WoodworkingDennis/ESP32_Watercooling_3D-Printer/README.md

<h1>ESP32_Watercooling_3D-Printer</h1>
<p>
</br>Ansteuerung von drei unabhängingen PWM-Geräten
</br>Auslesen von sechs verschiedenen PT100 Widerständen
</br>Anzeige und Einstellungen über LCD-Display
</br>ESP32 auf Custom PCB
</p>
