WoodworkingDennis/ESP32_Watercooling_3D-Printer/Custum PCB Design (KiCAD)/Schematic.pdf

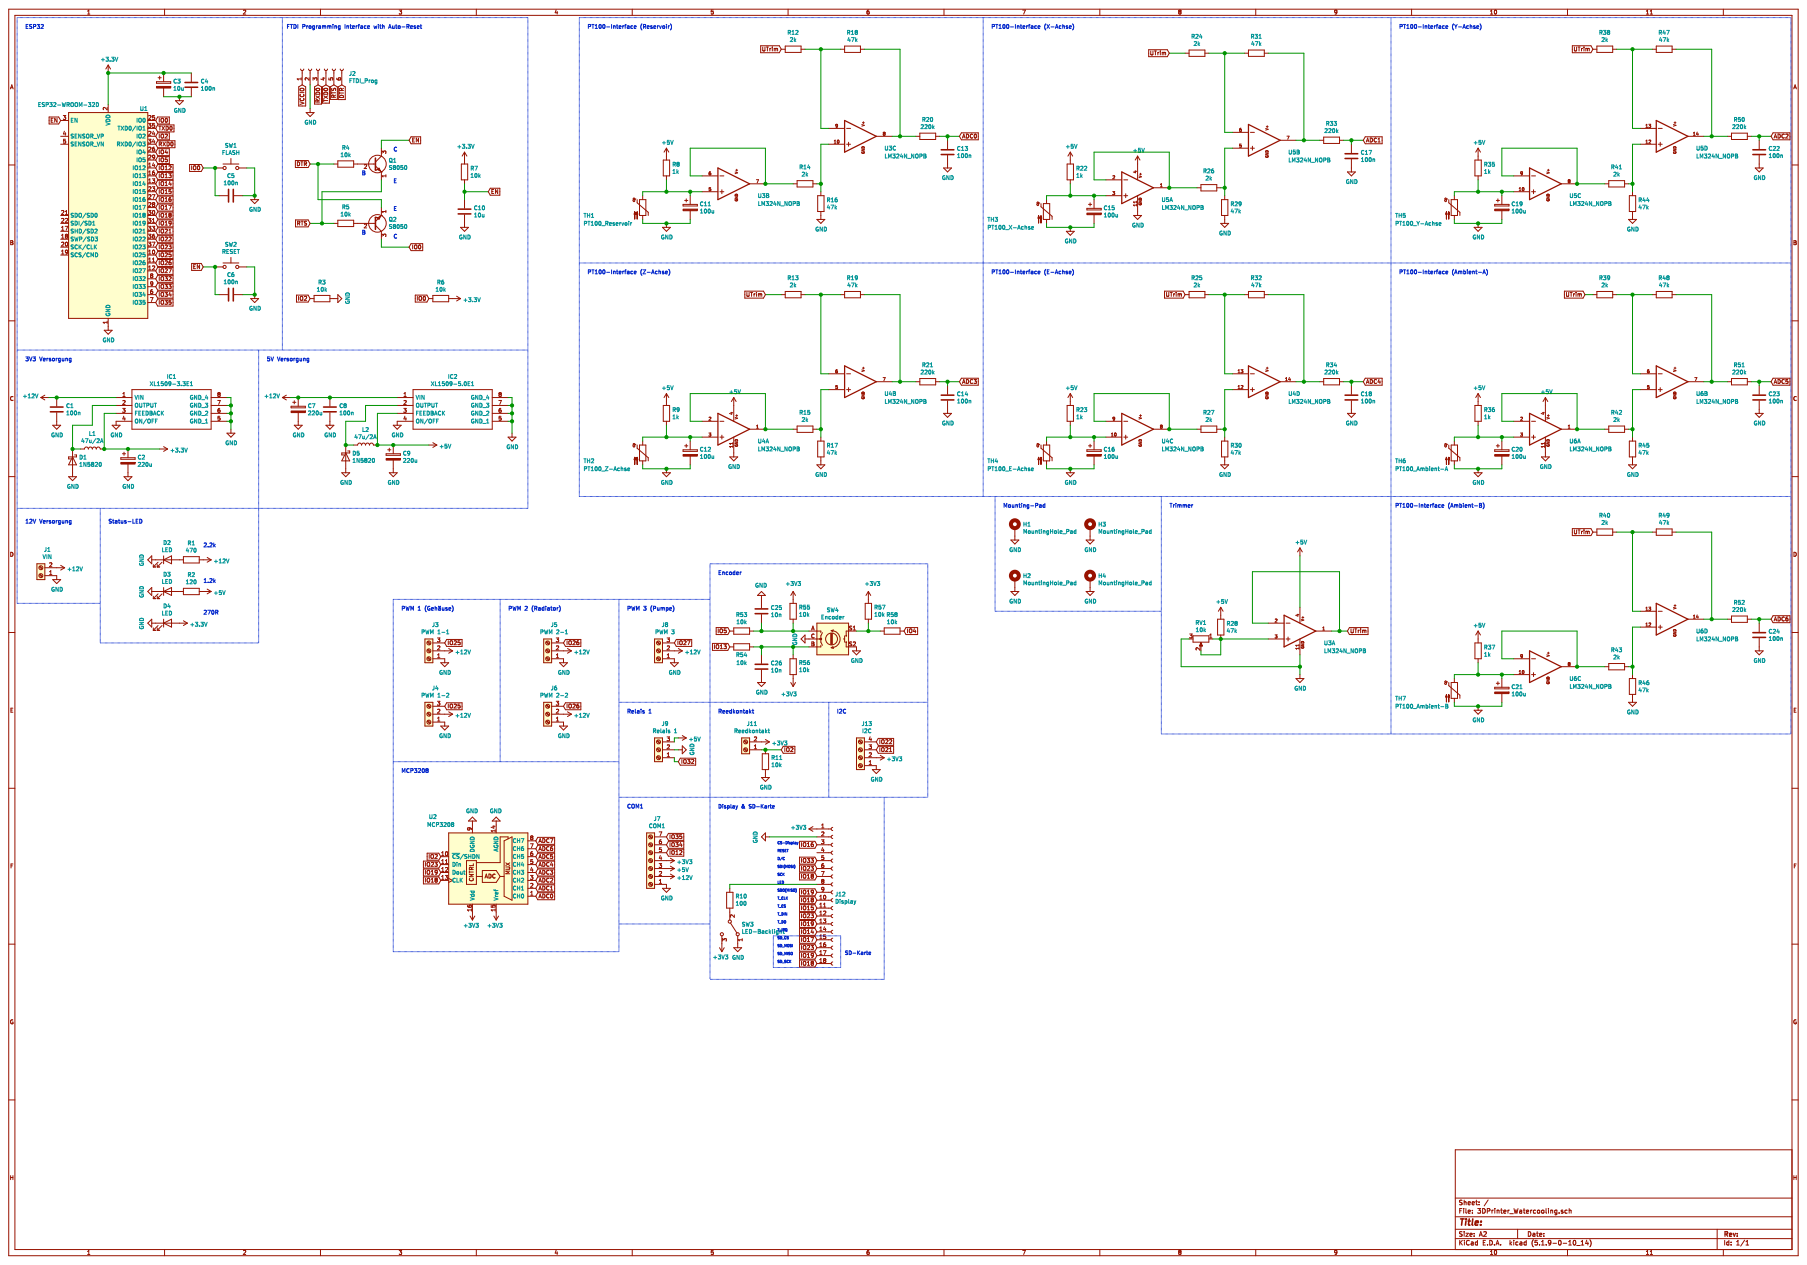
[picture p1: page 1]
