WoodworkingDennis/ESP32_Watercooling_3D-Printer/(list of files, drawings)

Other design files:
Custum PCB Design (KiCAD)/3DPrinter_Watercooling.dsn
