WoodworkingDennis/ESP32_Watercooling_3D-Printer/Custum PCB Design (KiCAD)/3DPrinter_Watercooling.kicad_pcb

## KiCad design Custum PCB Design (KiCAD)/3DPrinter_Watercooling.kicad_pcb (2021-02-17)

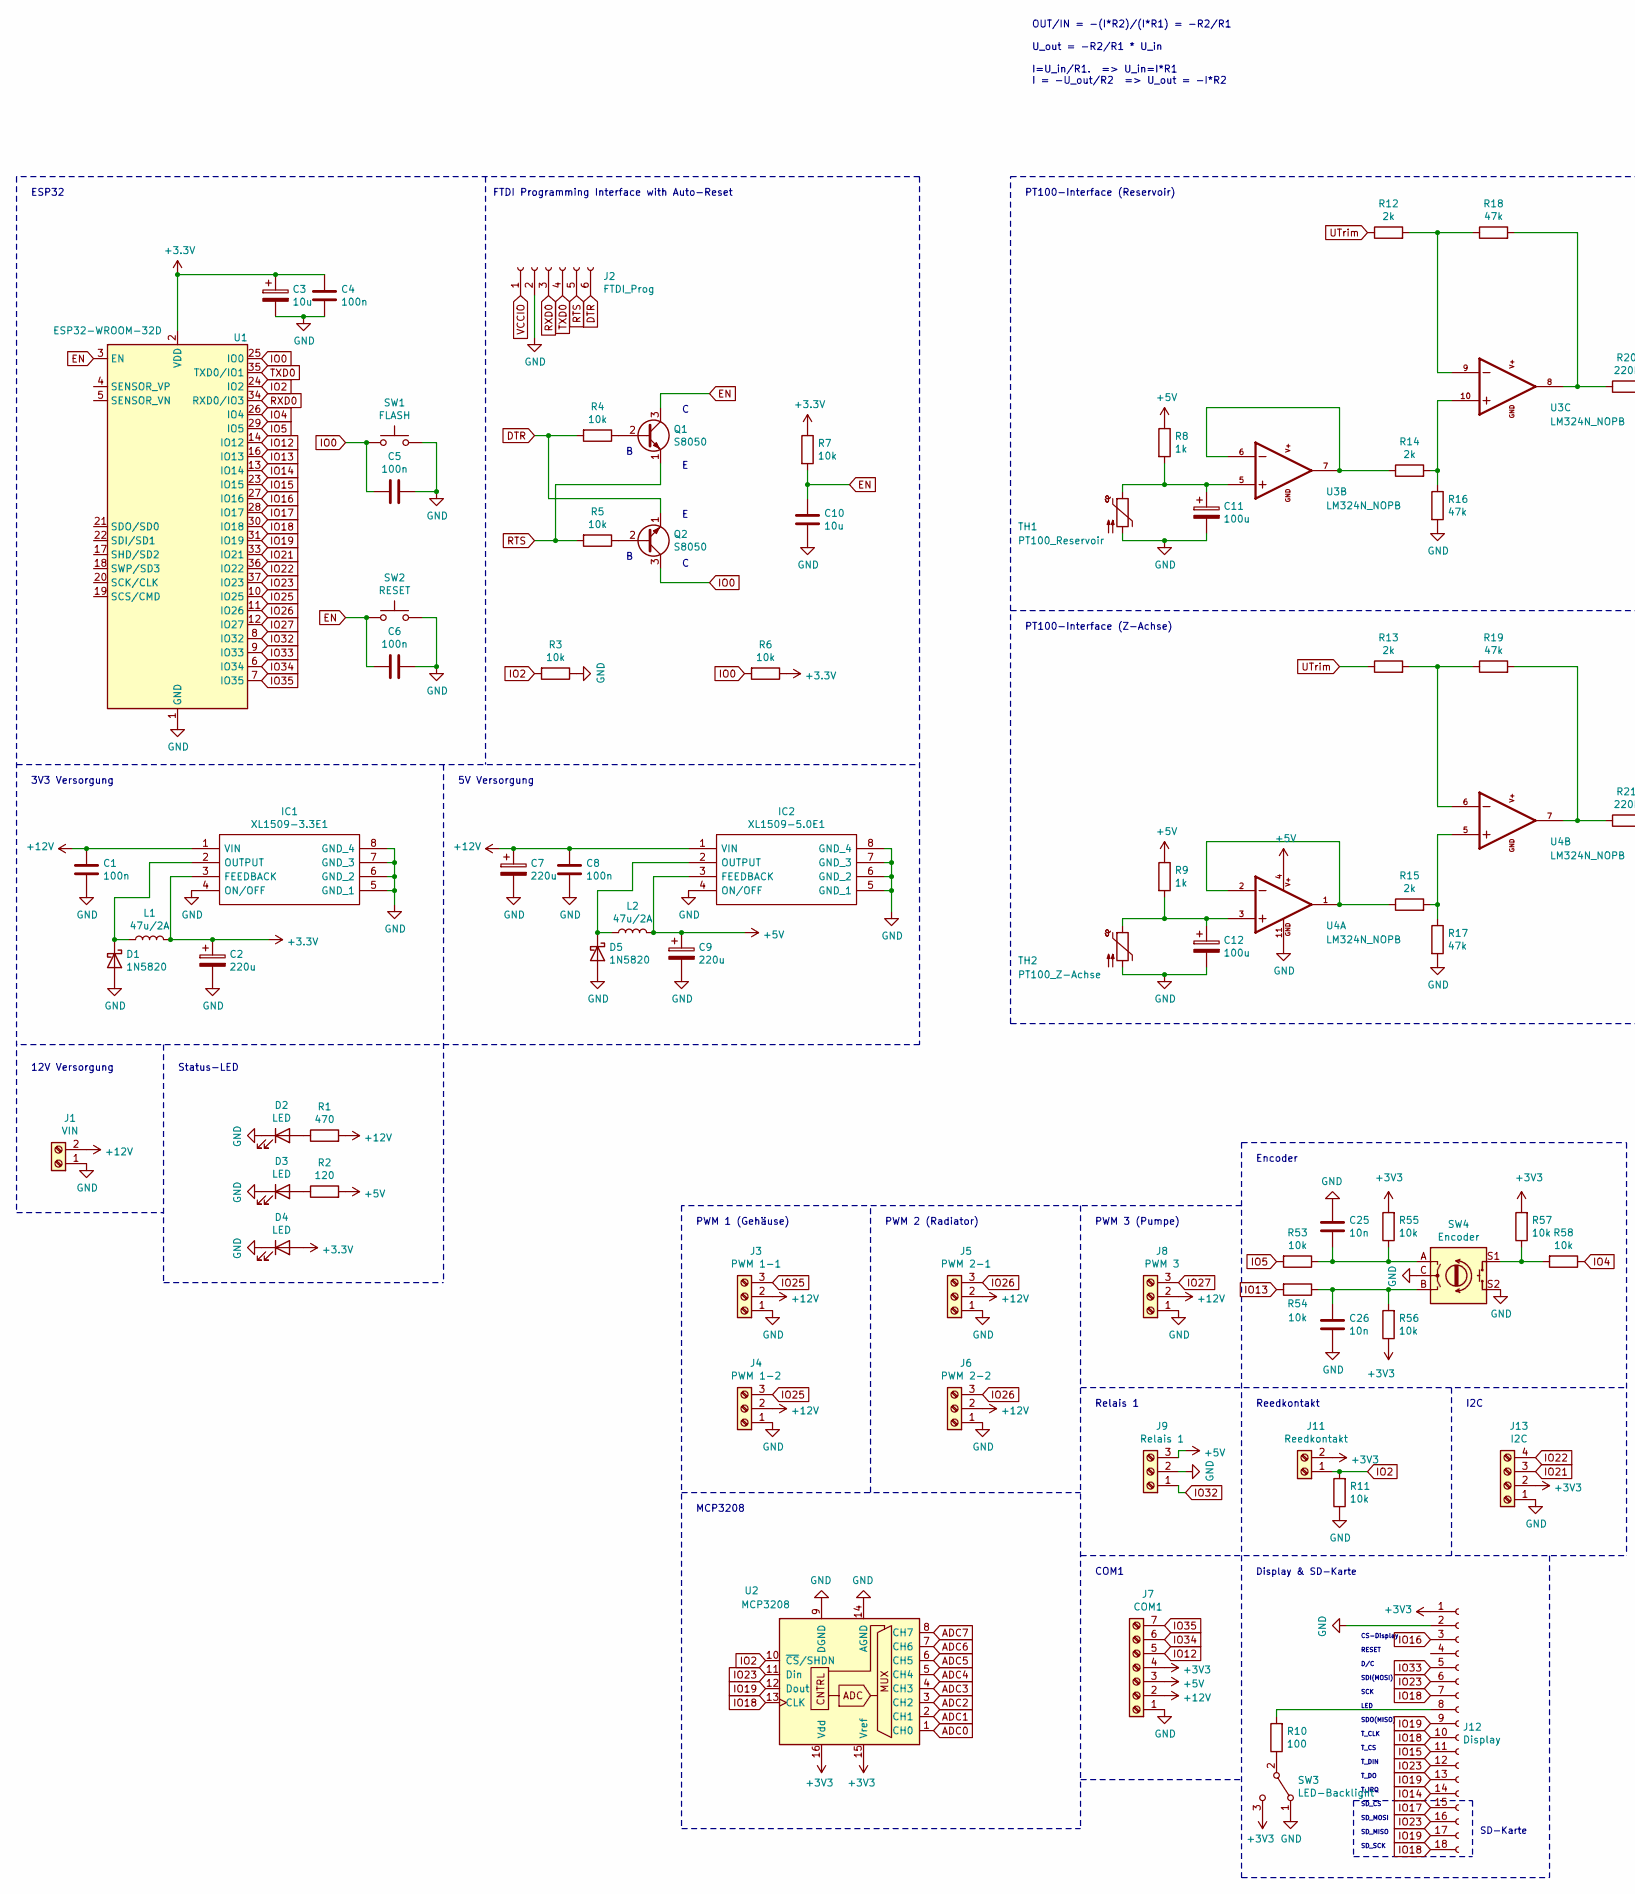
[picture p2: schematic 3DPrinter_Watercooling.sch, part in row 1, column 1]

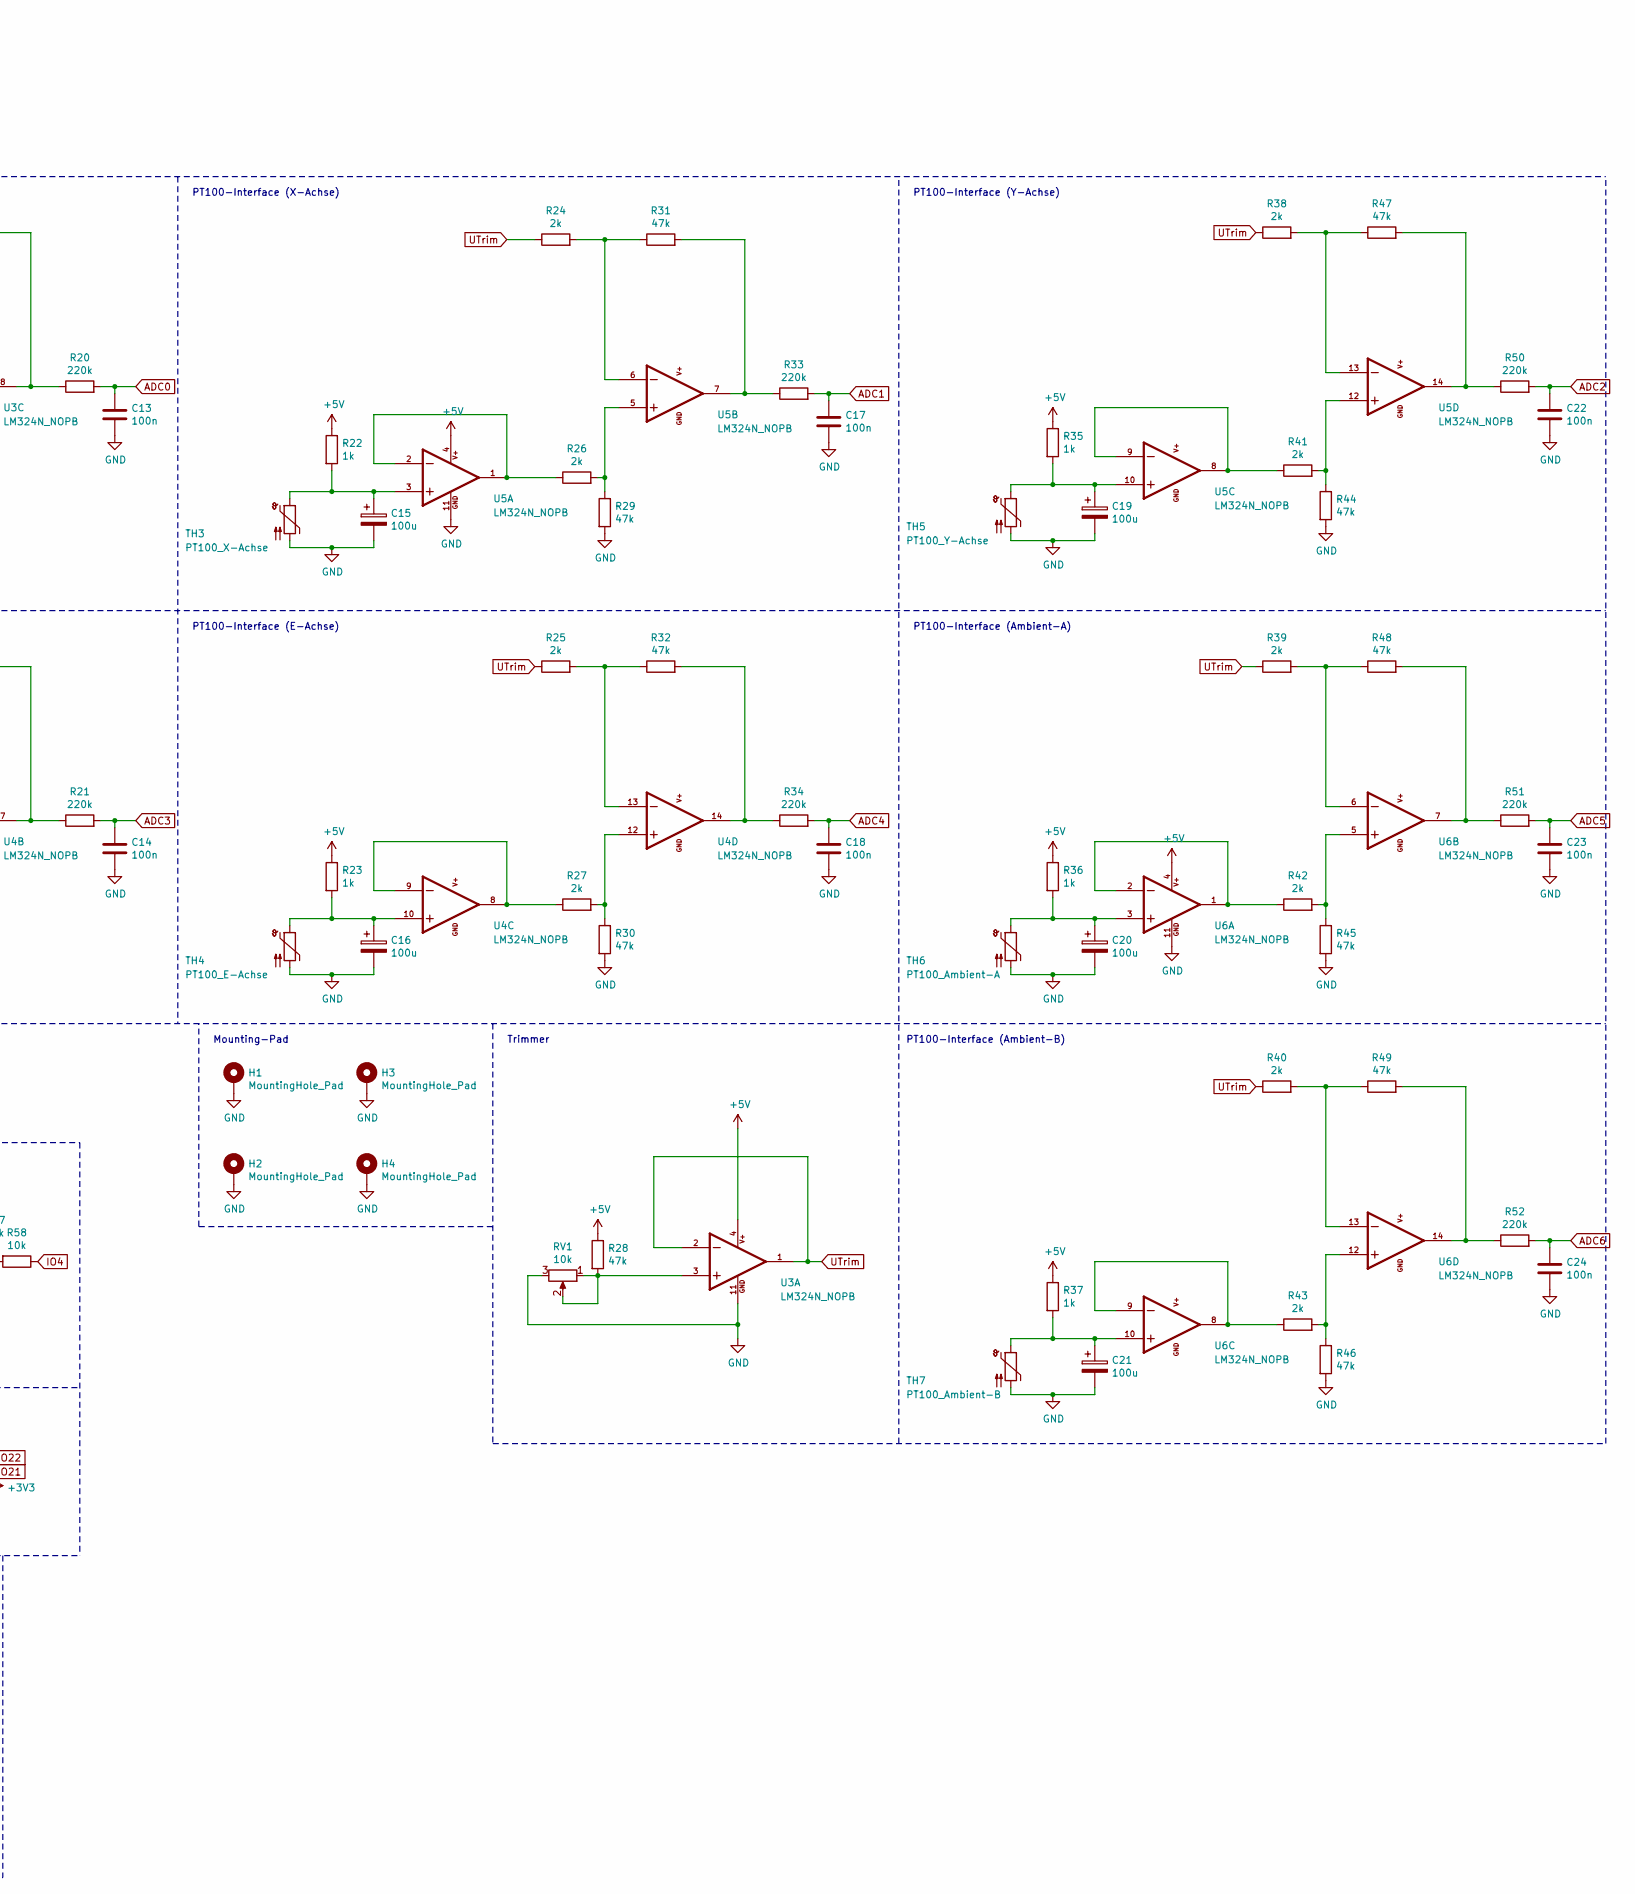
[picture p3: schematic 3DPrinter_Watercooling.sch, part in row 1, column 2]

Parts:
C1, C4, C5, C6, C8, C13, C14, C17, C18, C22, C23, C24: 100n; C_0805_2012Metric_Pad1.18x1.45mm_HandSolder
C2, C7, C9: 220u; CP_Radial_D6.3mm_P2.50mm
C3: 10u; CP_Radial_D4.0mm_P1.50mm
C10: 10u; C_0805_2012Metric_Pad1.18x1.45mm_HandSolder
C11, C12, C15, C16, C19, C20, C21: 100u; CP_Radial_D5.0mm_P2.00mm
C25, C26: 10n; C_0805_2012Metric_Pad1.18x1.45mm_HandSolder
D1, D5: 1N5820; D_DO-201AD_P15.24mm_Horizontal
D2, D3, D4: LED; LED_0805_2012Metric_Pad1.15x1.40mm_HandSolder
H1, H2, H3, H4: MountingHole_Pad; MountingHole_2.2mm_M2_Pad_Via
IC1: XL1509-3.3E1; SOIC127P600X175-8N; Manufacturer_Part_Number XL1509-3.3E1
IC2: XL1509-5.0E1; SOIC127P600X175-8N; Manufacturer_Part_Number XL1509-5.0E1
J1: VIN; WJ301V-5.0-2P
J2: FTDI_Prog; PinHeader_1x06_P2.54mm_Vertical
J3: PWM 1-1; TE_282834-3
J4: PWM 1-2; TE_282834-3
J5: PWM 2-1; TE_282834-3
J6: PWM 2-2; TE_282834-3
J7: COM1; TE_282834-7
J8: PWM 3; TE_282834-3
J9: Relais 1; TE_282834-3
J11: Reedkontakt; TE_282834-2
J12: Display; 3.2 inch 320 240 SPI Serial TFT LCD Module
J13: I2C; TE_282834-4
L1, L2: 47u/2A; L_Radial_D10.0mm_P5.00mm_Fastron_07M
Q1, Q2: S8050; TO-92_Inline
R1: 470; R_Axial_DIN0207_L6.3mm_D2.5mm_P7.62mm_Horizontal
R2: 120; R_Axial_DIN0207_L6.3mm_D2.5mm_P7.62mm_Horizontal
R3, R4, R5, R6, R7, R11, R53, R54, R55, R56, R57, R58: 10k; R_Axial_DIN0207_L6.3mm_D2.5mm_P7.62mm_Horizontal
R8, R9, R22, R23, R35, R36, R37: 1k; R_Axial_DIN0207_L6.3mm_D2.5mm_P7.62mm_Horizontal
R10: 100; R_Axial_DIN0207_L6.3mm_D2.5mm_P7.62mm_Horizontal
R12, R13, R14, R15, R24, R25, R26, R27, R38, R39, R40, R41, R42, R43: 2k; R_Axial_DIN0207_L6.3mm_D2.5mm_P7.62mm_Horizontal
R16, R17, R18, R19, R28, R29, R30, R31, R32, R44, R45, R46, R47, R48, R49: 47k; R_Axial_DIN0207_L6.3mm_D2.5mm_P7.62mm_Horizontal
R20, R21, R33, R34, R50, R51, R52: 220k; R_Axial_DIN0207_L6.3mm_D2.5mm_P7.62mm_Horizontal
RV1: 10k; Potentiometer_Bourns_3296W_Vertical
SW1: FLASH; TS-1187A-B-A-B
SW2: RESET; TS-1187A-B-A-B
SW3: LED-Backlight; SW_Slide_1P2T_CK_OS102011MS2Q
SW4: Encoder; RotaryEncoder_Alps_EC11E-Switch_Vertical_H20mm
TH1: PT100_Reservoir; TE_282834-2
TH2: PT100_Z-Achse; TE_282834-2
TH3: PT100_X-Achse; TE_282834-2
TH4: PT100_E-Achse; TE_282834-2
TH5: PT100_Y-Achse; TE_282834-2
TH6: PT100_Ambient-A; TE_282834-2
TH7: PT100_Ambient-B; TE_282834-2
U1: ESP32-WROOM-32D; ESP32-WROOM-32
U2: MCP3208; SOIC127P600X175-16N
U3, U4, U5, U6: LM324N_NOPB; SOIC-14_3.9x8.7mm_P1.27mm; PARTREV D

Connections:
+5V: C9.1, IC2.3 (FEEDBACK), J7.3, J9.3, L2.2, R2.2, R8.1, R9.1, R22.1, R23.1, R28.1, R35.1, R36.1, R37.1, U3.4, U4.4, U5.4, U6.4
+12V: C1.1, C7.1, C8.1, IC1.1 (VIN), IC2.1 (VIN), J1.2, J3.2, J4.2, J5.2, J6.2, J7.2, J8.2, R1.2
ADC0: C13.1, R20.2, U2.1 (CH0)
ADC1: C17.1, R33.2, U2.2 (CH1)
ADC2: C22.1, R50.2, U2.3 (CH2)
ADC3: C14.1, R21.2, U2.4 (CH3)
ADC4: C18.1, R34.2, U2.5 (CH4)
ADC5: C23.1, R51.2, U2.6 (CH5)
ADC6: C24.1, R52.2, U2.7 (CH6)
ADC7: U2.8 (CH7)
DTR: J2.6, Q2.1 (E), R4.2
EN: C6.2, C10.1, Q1.3 (C), R7.2, SW2.1, U1.3 (EN)
GND: C1.2, C2.2, C3.2, C4.2, C5.1, C6.1, C7.2, C8.2, C9.2, C10.2, C11.2, C12.2, C13.2, C14.2, C15.2, C16.2, C17.2, C18.2, C19.2, C20.2, C21.2, C22.2, C23.2, C24.2, C25.1, C26.2, D1.2 (A), D2.1 (K), D3.1 (K), D4.1 (K), D5.2 (A), H1.1, H2.1, H3.1, H4.1, IC1.4 (ON/OFF), IC1.5 (GND_1), IC1.6 (GND_2), IC1.7 (GND_3), IC1.8 (GND_4), IC2.4 (ON/OFF), IC2.5 (GND_1), IC2.6 (GND_2), IC2.7 (GND_3), IC2.8 (GND_4), J1.1, J2.2, J3.1, J4.1, J5.1, J6.1, J7.1, J8.1, J9.2, J12.2, J13.1, R3.1, R11.1, R16.2, R17.2, R29.2, R30.2, R44.2, R45.2, R46.2, RV1.3, SW1.2, SW2.2, SW3.1 (A), SW4.C, SW4.S2, TH1.2, TH2.2, TH3.2, TH4.2, TH5.2, TH6.2, TH7.2, U1.1 (GND), U1.15 (GND), U1.38 (GND), U1.39 (GND), U2.9 (DGND), U2.14 (AGND), U3.11, U4.11, U5.11, U6.11
IO0: C5.2, Q2.3 (C), R6.2, SW1.1, U1.25 (IO0)
IO2: J11.1, R3.2, R11.2, U1.24 (IO2), U2.10 (~CS~/SHDN)
IO4: R58.1, U1.26 (IO4)
IO5: R53.2, U1.29 (IO5)
IO12: J7.5, U1.14 (IO12)
IO13: R54.2, U1.16 (IO13)
IO14: J12.14, U1.13 (IO14)
IO15: J12.11, U1.23 (IO15)
IO16: J12.3, U1.27 (IO16)
IO17: J12.15, U1.28 (IO17)
IO18: J12.7, J12.10, J12.18, U1.30 (IO18), U2.13 (CLK)
IO19: J12.9, J12.13, J12.17, U1.31 (IO19), U2.12 (Dout)
IO21: J13.3, U1.33 (IO21)
IO22: J13.4, U1.36 (IO22)
IO23: J12.6, J12.12, J12.16, U1.37 (IO23), U2.11 (Din)
IO25: J3.3, J4.3, U1.10 (IO25)
IO26: J5.3, J6.3, U1.11 (IO26)
IO27: J8.3, U1.12 (IO27)
IO32: J9.1, U1.8 (IO32)
IO33: J12.5, U1.9 (IO33)
IO34: J7.6, U1.6 (IO34)
IO35: J7.7, U1.7 (IO35)
unnamed: C11.1, R8.2, TH1.1, U3.5
unnamed: C12.1, R9.2, TH2.1, U4.3
unnamed: C15.1, R22.2, TH3.1, U5.3
unnamed: C16.1, R23.2, TH4.1, U4.10
unnamed: C19.1, R35.2, TH5.1, U5.10
unnamed: C20.1, R36.2, TH6.1, U6.3
unnamed: C21.1, R37.2, TH7.1, U6.10
unnamed: C25.2, R53.1, R55.1, SW4.A
unnamed: C26.1, R54.1, R56.2, SW4.B
unnamed: D1.1 (K), IC1.2 (OUTPUT), L1.1
unnamed: D2.2 (A), R1.1
unnamed: D3.2 (A), R2.1
unnamed: D5.1 (K), IC2.2 (OUTPUT), L2.1
unnamed: J12.8, R10.2
unnamed: Q1.2 (B), R4.1
unnamed: Q2.2 (B), R5.1
unnamed: R10.1, SW3.2 (B)
unnamed: R12.2, R18.1, U3.9
unnamed: R13.2, R19.1, U4.6
unnamed: R14.1, U3.6, U3.7
unnamed: R14.2, R16.1, U3.10
unnamed: R15.1, U4.1, U4.2
unnamed: R15.2, R17.1, U4.5
unnamed: R18.2, R20.1, U3.8
unnamed: R19.2, R21.1, U4.7
unnamed: R24.2, R31.1, U5.6
unnamed: R25.2, R32.1, U4.13
unnamed: R26.1, U5.1, U5.2
unnamed: R26.2, R29.1, U5.5
unnamed: R27.1, U4.8, U4.9
unnamed: R27.2, R30.1, U4.12
unnamed: R28.2, RV1.1, RV1.2, U3.3
unnamed: R31.2, R33.1, U5.7
unnamed: R32.2, R34.1, U4.14
unnamed: R38.2, R47.1, U5.13
unnamed: R39.2, R48.1, U6.6
unnamed: R40.2, R49.1, U6.13
unnamed: R41.1, U5.8, U5.9
unnamed: R41.2, R44.1, U5.12
unnamed: R42.1, U6.1, U6.2
unnamed: R42.2, R45.1, U6.5
unnamed: R43.1, U6.8, U6.9
unnamed: R43.2, R46.1, U6.12
unnamed: R47.2, R50.1, U5.14
unnamed: R48.2, R51.1, U6.7
unnamed: R49.2, R52.1, U6.14
unnamed: R57.1, R58.2, SW4.S1
RTS: J2.5, Q1.1 (E), R5.2
RXD0: J2.3, U1.34 (RXD0/IO3)
TXD0: J2.4, U1.35 (TXD0/IO1)
UTrim: R12.1, R13.1, R24.1, R25.1, R38.1, R39.1, R40.1, U3.1, U3.2
VCCIO: J2.1

Notes on the sheet:
ESP32
FTDI Programming Interface with Auto-Reset
PT100-Interface (Reservoir)
Mounting-Pad
PT100-Interface (X-Achse)
PT100-Interface (Y-Achse)
PT100-Interface (Z-Achse)
PT100-Interface (Ambient-A)
PT100-Interface (Ambient-B)
Display & SD-Karte
SD-Karte
SD_SCK
SD_MISO
SD_MOSI
SD_CS
T_IRQ
T_DO
T_DIN
T_CS
T_CLK
SDO(MISO)
LED
SCK
SDI(MOSI)
D/C
RESET
CS-Display
COM1
MCP3208
Reedkontakt
Relais 1
Encoder
PWM 3 (Pumpe)
PWM 2 (Radiator)
PWM 1 (Gehäuse)
3V3 Versorgung
12V Versorgung
OUT/IN = -(I*R2)/(I*R1) = -R2/R1 U_out = -R2/R1 * U_in I=U_in/R1. => U_in=I*R1 I = -U_out/R2 => U_out = -I*R2
Trimmer
PT100-Interface (E-Achse)
I2C
5V Versorgung
Status-LED

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
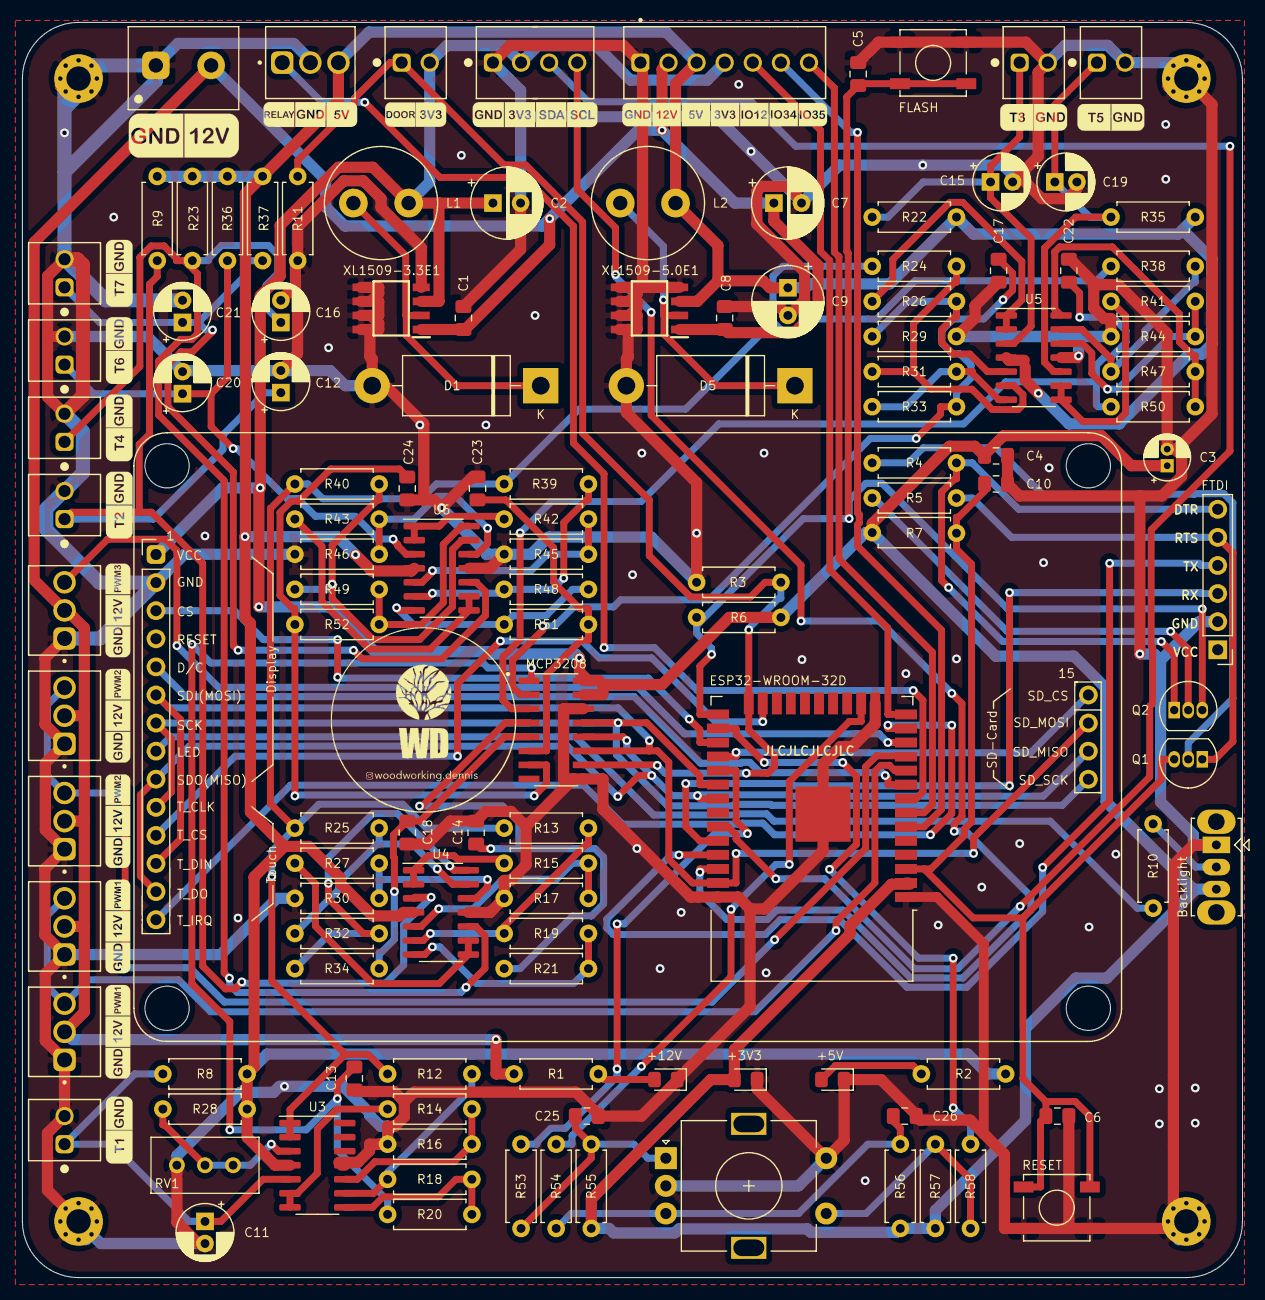
[picture p4: board 3DPrinter_Watercooling.kicad_pcb from above]

Board: 2 copper layers, 110.3 x 113.5 mm, 146 parts (0 on the bottom side), 86 nets.

Other parts of the board:
G1: LOGO; T5-GND_6x2.4 mm
G2: LOGO; T3-GND_6x2.4 mm
G3: LOGO; COM1
G4: LOGO; I2C
G5: LOGO; DOOR-3V3
G6: LOGO; Relay-GND-5V
G7: LOGO; 12V-GND_10x4 mm
G8: LOGO; T7-GND_6x2.4 mm
G9: LOGO; T6-GND_6x2.4 mm
G10: LOGO; T4-GND_6x2.4 mm
G11: LOGO; T2-GND_6x2.4 mm
G12: LOGO; GND-12V-PWM3
G13, G14: LOGO; GND-12V-PWM2
G15, G16: LOGO; GND-12V-PWM1
G17: LOGO; T1-GND_6x2.4 mm
